tonymauro/HiboticsPi/Code/README.md

To install adc libraries type the following in terminal:
```bash
sudo apt-get update
sudo apt-get install build-essential python-dev python-smbus python-pip
sudo pip install adafruit-mcp3008
```
Other libraries can be installed using:
```bash
sudo pip install <name_of_library>
```
