tonymauro/HiboticsPi/Schematics/Full Size/Electronics-final.brd

## EAGLE design Schematics/Full Size/Electronics-final.brd (2019-06-18)

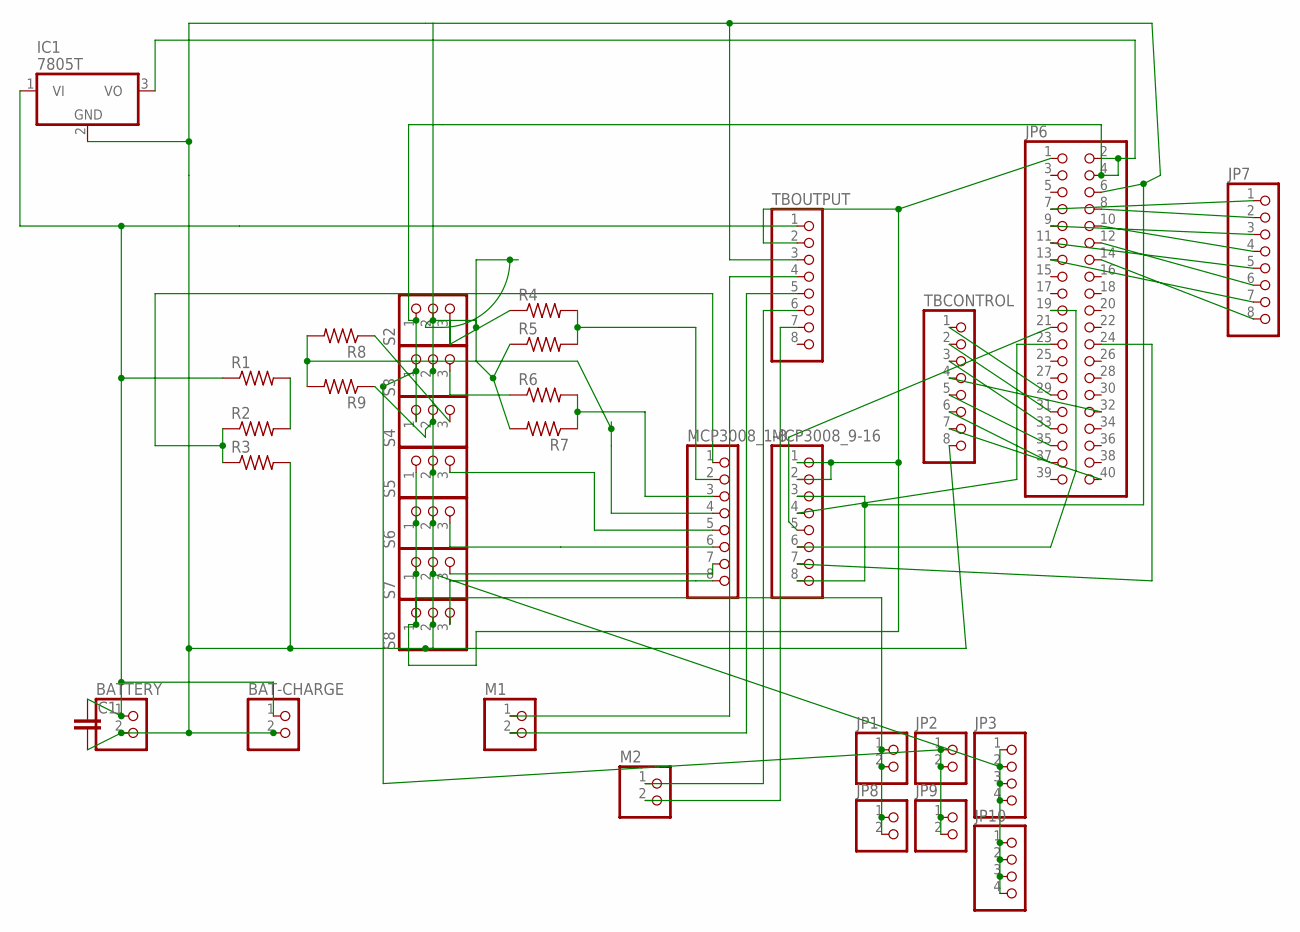
[picture p1: schematic Electronics-final.sch]

Parts:
BAT-CHARGE: PINHD-1X2; 1X02
BATTERY: PINHD-1X2; 1X02
C1: C-EU050-035X075; C050-035X075
IC1: 7805T; TO220H
JP1, JP2, JP8, JP9: PINHD-1X2; 1X02
JP3, JP10: PINHD-1X4; 1X04
JP6: PINHD-2X20; 2X20
JP7: PINHD-1X8; 1X08
M1, M2: PINHD-1X2; 1X02
MCP3008_1-8, MCP3008_9-16: PINHD-1X8; 1X08
R1, R2, R3, R4, R5, R6, R7, R8, R9: R-US_0204/7; 0204/7
S2, S3, S4, S5, S6, S7, S8: PINHD-1X3; 1X03
TBCONTROL: PINHD-1X8; 1X08
TBOUTPUT: PINHD-1X8; 1X08

Connections:
3.3V: JP1.1, JP1.2, JP6.1, JP8.1, JP8.2, MCP3008_9-16.1, MCP3008_9-16.2, S5.1, S6.1, S7.1, S8.1, TBOUTPUT.2
5V: IC1.3 (VO), JP2.1, JP2.2, JP6.2, JP6.4, JP9.1, JP9.2, S2.1, S3.1, S4.1
7: JP6.7, JP7.1
8: JP6.8, JP7.2
9: JP6.9, JP7.3
10: JP6.10, JP7.4
11: JP6.11, JP7.5
12: JP6.12, JP7.6
13: JP6.13, JP7.7
14: JP6.14, JP7.8
GND: BAT-CHARGE.2, BATTERY.2, C1.2, IC1.2 (GND), JP3.1, JP3.2, JP3.3, JP3.4, JP6.6, JP10.1, JP10.2, JP10.3, JP10.4, MCP3008_9-16.3, MCP3008_9-16.8, R3.2, R5.1, R7.2, R9.1, S2.2, S3.2, S4.2, S5.2, S6.2, S7.2, S8.2, TBCONTROL.8, TBOUTPUT.3
unnamed: JP6.40, TBCONTROL.7
unnamed: JP6.32, TBCONTROL.4
unnamed: R1.2, R2.2
unnamed: JP6.37, TBCONTROL.6
unnamed: JP6.35, TBCONTROL.5
unnamed: JP6.33, TBCONTROL.3
unnamed: JP6.31, TBCONTROL.2
unnamed: JP6.29, TBCONTROL.1
unnamed: JP6.23, MCP3008_9-16.4
unnamed: JP6.21, MCP3008_9-16.5
unnamed: M1.1, TBOUTPUT.4
unnamed: M1.2, TBOUTPUT.5
unnamed: M2.1, TBOUTPUT.6
unnamed: M2.2, TBOUTPUT.7
unnamed: JP6.19, MCP3008_9-16.6
unnamed: JP6.24, MCP3008_9-16.7
S1: R4.1, S2.3
S1H: MCP3008_1-8.2, R4.2, R5.2
S2: R6.1, S3.3
S2H: MCP3008_1-8.3, R6.2, R7.1
S3: R8.1, S4.3
S3H: MCP3008_1-8.4, R8.2, R9.2
S4: MCP3008_1-8.5, S5.3
S5: MCP3008_1-8.6, S6.3
S6: MCP3008_1-8.7, S7.3
S7: MCP3008_1-8.8, S8.3
VIN: BAT-CHARGE.1, BATTERY.1, C1.1, IC1.1 (VI), R1.1, TBOUTPUT.1
VINH: MCP3008_1-8.1, R2.1, R3.1

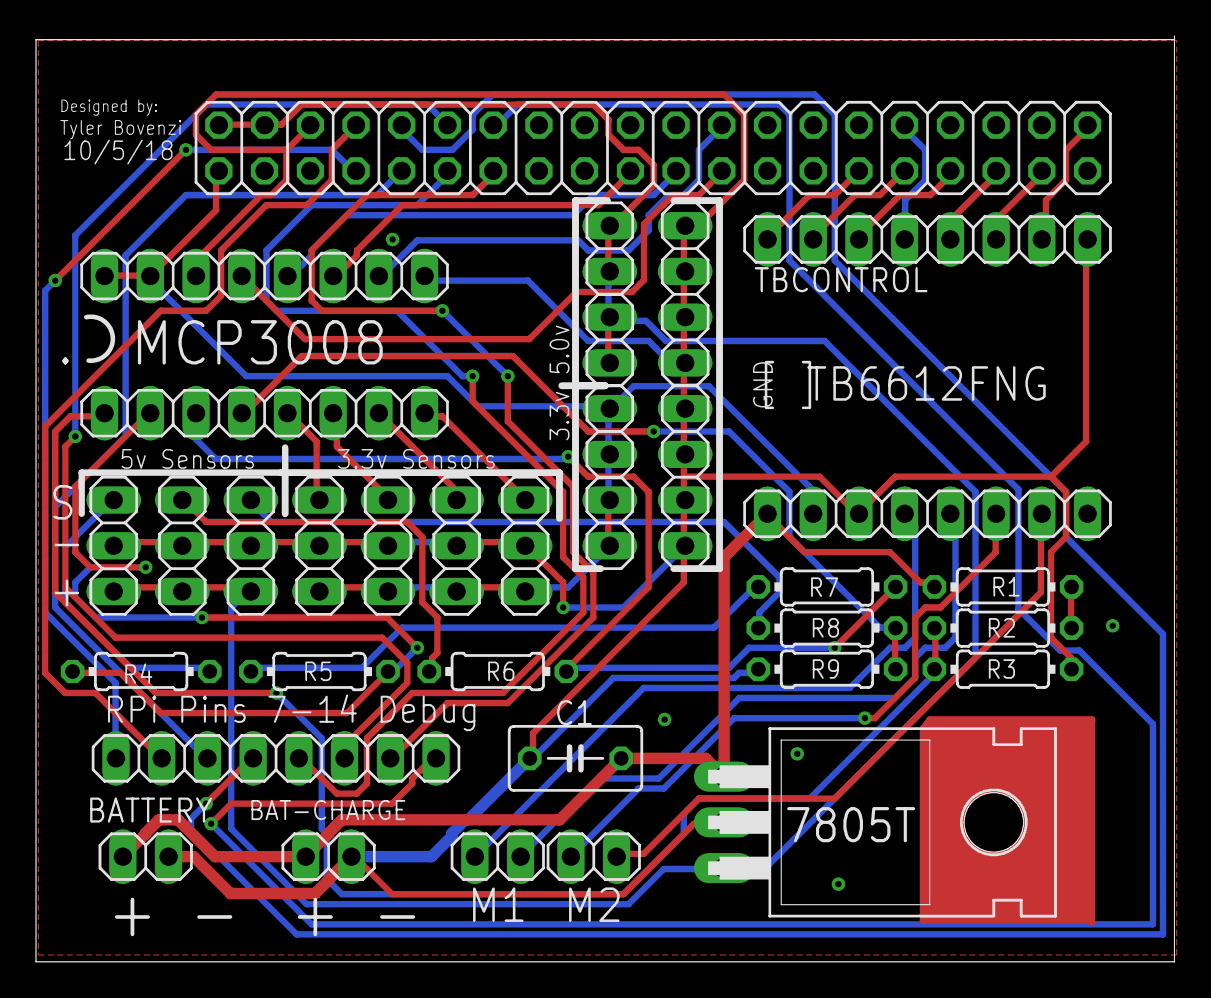
[picture p2: board Electronics-final.brd from above]

Board: 2 copper layers, 63.3 x 51.4 mm, 34 parts (0 on the bottom side), 39 nets.
