tonymauro/HiboticsPi/Schematics/Zero Size/Zerow.brd

## EAGLE design Schematics/Zero Size/Zerow.brd (2019-06-18)

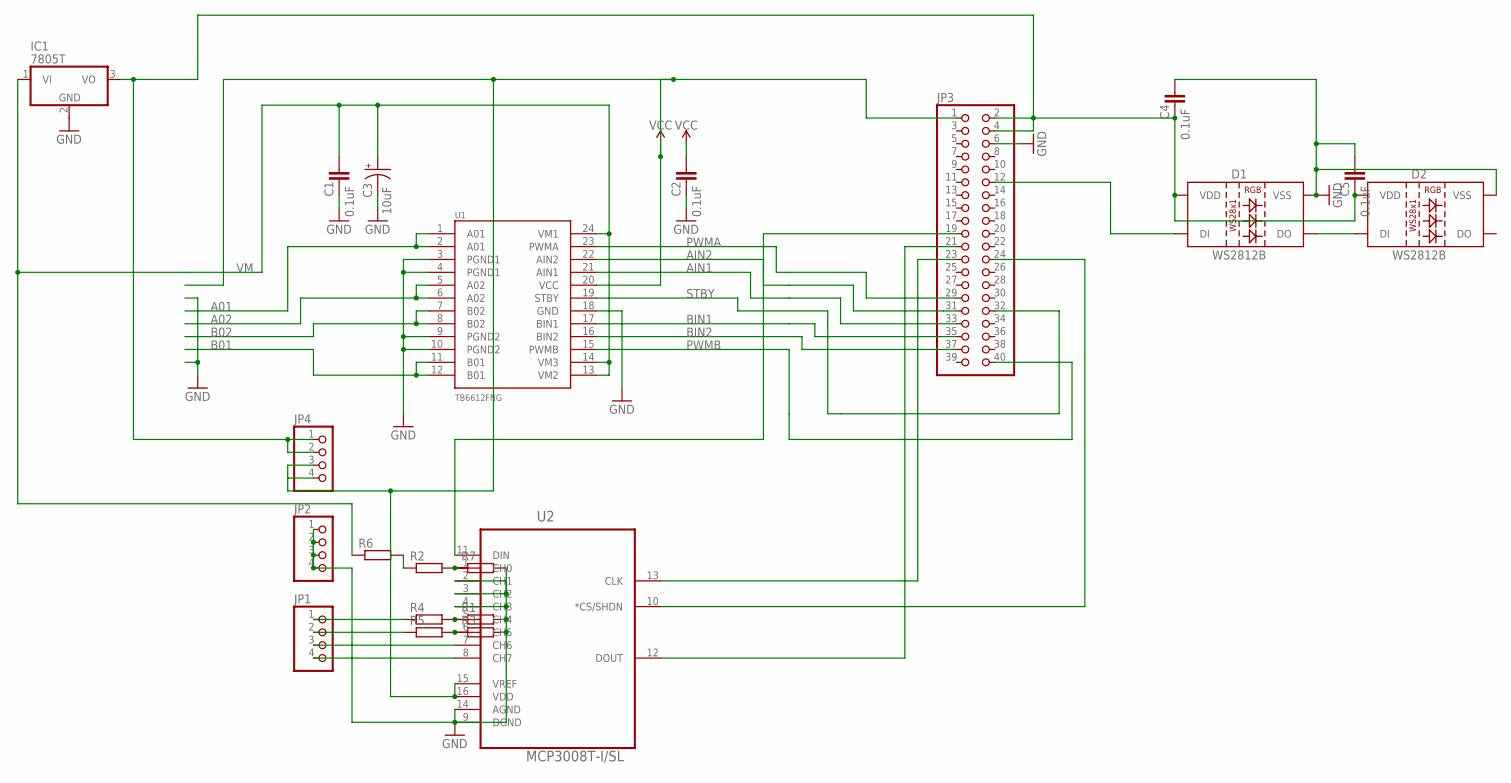
[picture p3: schematic Zerow.sch, sheet 2]

Parts:
C1, C2, C4, C5: 0.1uF; 0402
C3: 10uF; EIA3528
D1, D2: WS2812B
IC1: 7805T; TO220H
JP1, JP2, JP4: PINHD-1X4; 1X04
JP3: PINHD-2X20; 2X20
R1, R2, R3, R4, R5, R6, R7: R-EU_R0805; R0805
U1: TB6612FNG; SSOP24
U2: MCP3008T-I/SL; SOIC127P600X175-16N

Connections:
5V: C4.2, C5.2, D1.1 (VDD), D2.1 (VDD), IC1.3 (VO), JP3.2, JP3.4, JP4.1, JP4.2
A01: U1.1 (A01), U1.2 (A01)
A02: U1.5 (A02), U1.6 (A02)
AIN1: JP3.33, U1.21 (AIN1)
AIN2: JP3.31, U1.22 (AIN2)
B01: U1.11 (B01), U1.12 (B01)
B02: U1.7 (B02), U1.8 (B02)
BIN1: JP3.35, U1.17 (BIN1)
BIN2: JP3.37, U1.16 (BIN2)
GND: C1.2, C2.2, C3.C (-), C4.1, C5.1, D1.3 (VSS), D2.3 (VSS), IC1.2 (GND), JP2.1, JP2.2, JP2.3, JP2.4, JP3.6, R1.2, R3.2, R7.2, U1.3 (PGND1), U1.4 (PGND1), U1.9 (PGND2), U1.10 (PGND2), U1.18 (GND), U2.2 (CH1), U2.3 (CH2), U2.4 (CH3), U2.9 (DGND), U2.14 (AGND)
unnamed: JP3.23, U2.13 (CLK)
unnamed: JP3.19, U2.11 (DIN)
unnamed: JP3.21, U2.12 (DOUT)
unnamed: JP3.24, U2.10 (*CS/SHDN)
unnamed: JP1.4, U2.8 (CH7)
unnamed: JP1.3, U2.7 (CH6)
unnamed: R1.1, R4.2, U2.5 (CH4)
unnamed: R3.1, R5.2, U2.6 (CH5)
unnamed: JP1.1, R4.1
unnamed: JP1.2, R5.1
unnamed: R2.2, R7.1, U2.1 (CH0)
unnamed: R2.1, R6.2
unnamed: D1.4 (DI), JP3.12
unnamed: D1.2 (DO), D2.4 (DI)
PWMA: JP3.29, U1.23 (PWMA)
PWMB: JP3.40, U1.15 (PWMB)
STBY: JP3.32, U1.19 (STBY)
VCC: C2.1, JP3.1, JP4.3, JP4.4, U1.20 (VCC), U2.15 (VREF), U2.16 (VDD)
VM: C1.1, C3.A (+), IC1.1 (VI), R6.1, U1.13 (VM2), U1.14 (VM3), U1.24 (VM1)

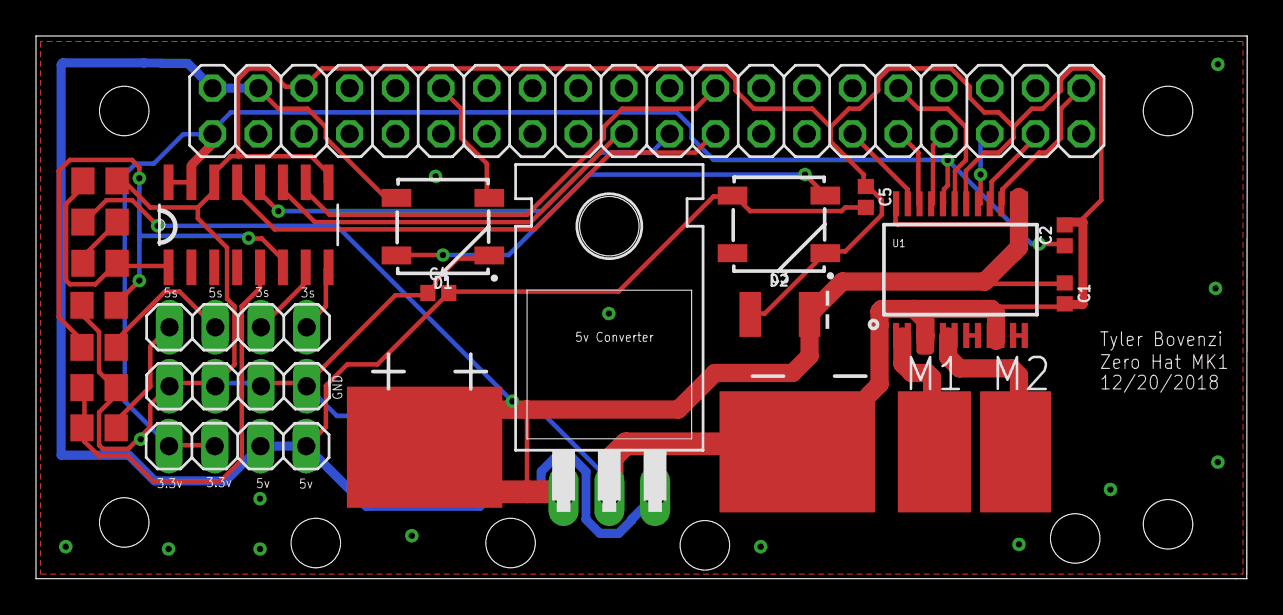
[picture p4: board Zerow.brd from above]

Board: 2 copper layers, 67.3 x 30.1 mm, 21 parts (0 on the bottom side), 29 nets.
